sphanhoang/Self-balancing-robot/BreakoutBoard/BreakoutBoard.pdf

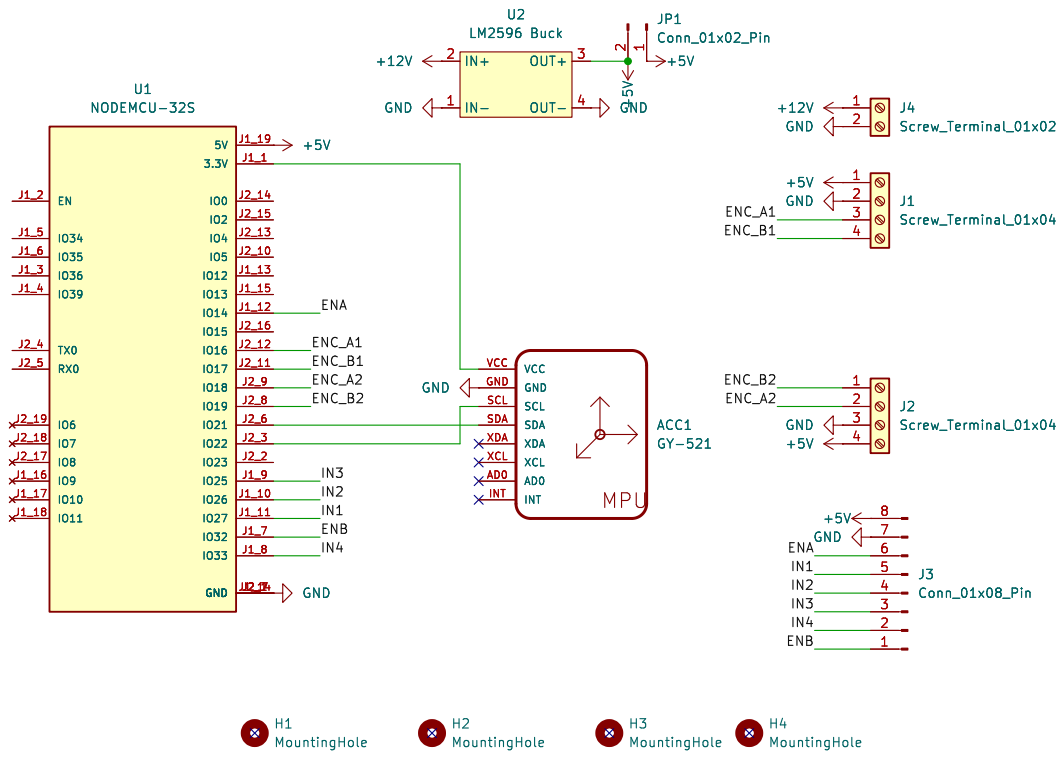
[picture p1: page 1]

Id: 1/1 Title: File: BreakoutBoard.kicad_sch Sheet: / MPU
