sphanhoang/Self-balancing-robot/BreakoutBoard/BreakoutBoard.kicad_pcb

## KiCad design BreakoutBoard/BreakoutBoard.kicad_pcb (2025-09-18)

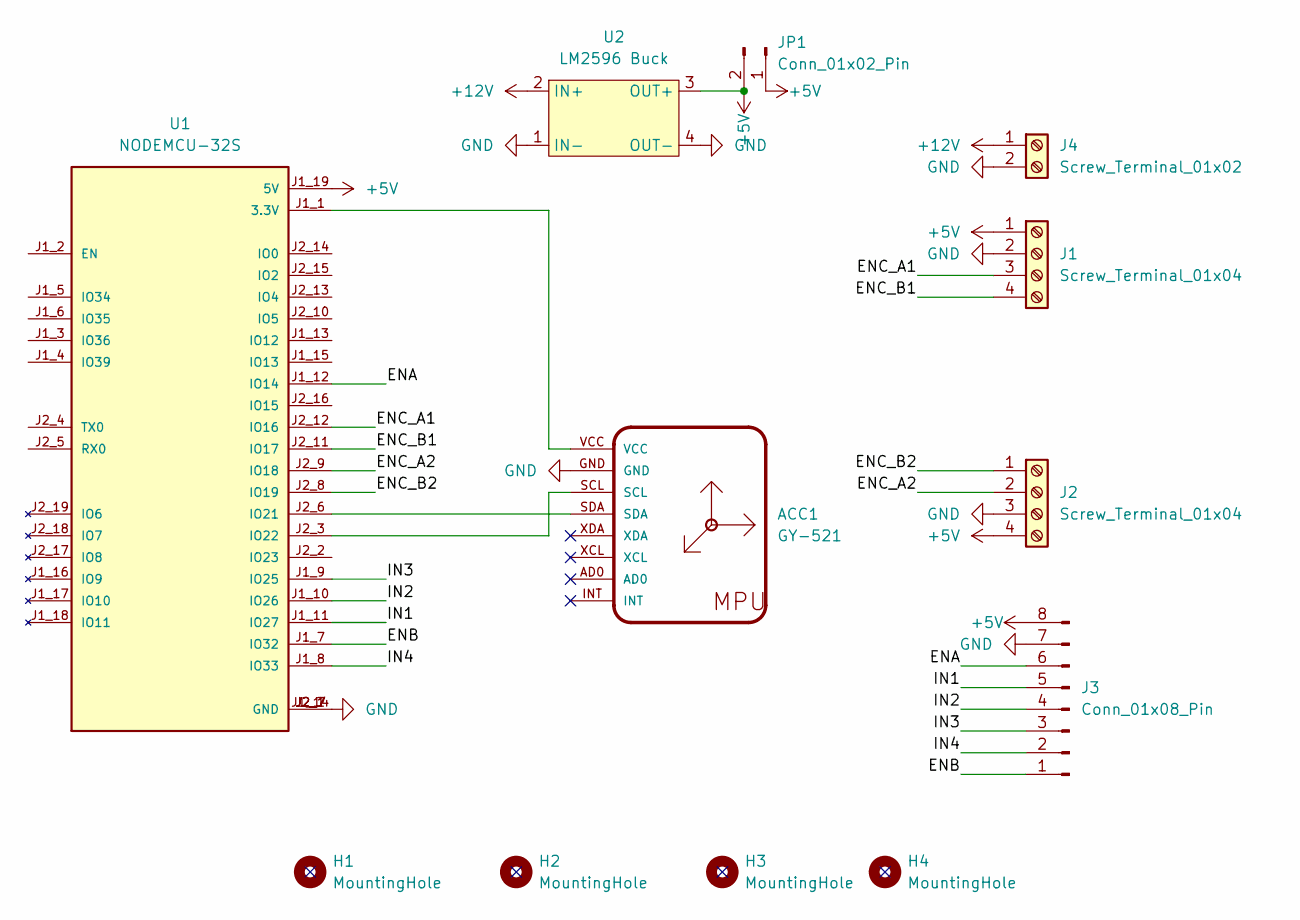
[picture p2: schematic BreakoutBoard.kicad_sch]

Parts:
ACC1: GY-521
H1, H2, H3, H4: MountingHole; MountingHole_3.2mm_M3_Pad
J1, J2: Screw_Terminal_01x04; ScrewTerminal_TB007-508-04BE
J3: Conn_01x08_Pin; PinHeader_1x08_P2.54mm_Vertical
J4: Screw_Terminal_01x02; ScrewTerminal_TB007-508-02BE
JP1: Conn_01x02_Pin; PinHeader_1x02_P2.54mm_Vertical
U1: NODEMCU-32S; ESP32-NODEMCU-32S; PARTREV V1
U2: LM2596 Buck; LM2596 WC00100 Module

Connections:
+5V: J1.1, J2.4, J3.8, JP1.1, JP1.2, U1.J1_19 (5V), U2.3 (OUT+)
+12V: J4.1, U2.2 (IN+)
/ENA: J3.6, U1.J1_12 (IO14)
/ENB: J3.1, U1.J1_7 (IO32)
/ENC_A1: J1.3, U1.J2_12 (IO16)
/ENC_A2: J2.2, U1.J2_9 (IO18)
/ENC_B1: J1.4, U1.J2_11 (IO17)
/ENC_B2: J2.1, U1.J2_8 (IO19)
/IN1: J3.5, U1.J1_11 (IO27)
/IN2: J3.4, U1.J1_10 (IO26)
/IN3: J3.3, U1.J1_9 (IO25)
/IN4: J3.2, U1.J1_8 (IO33)
GND: ACC1.GND, J1.2, J2.3, J3.7, J4.2, U1.J1_14 (GND), U1.J2_1 (GND), U1.J2_7 (GND), U2.1 (IN-), U2.4 (OUT-)
unnamed: ACC1.VCC, U1.J1_1 (3.3V)
unnamed: ACC1.SDA, U1.J2_6 (IO21)
unnamed: ACC1.SCL, U1.J2_3 (IO22)

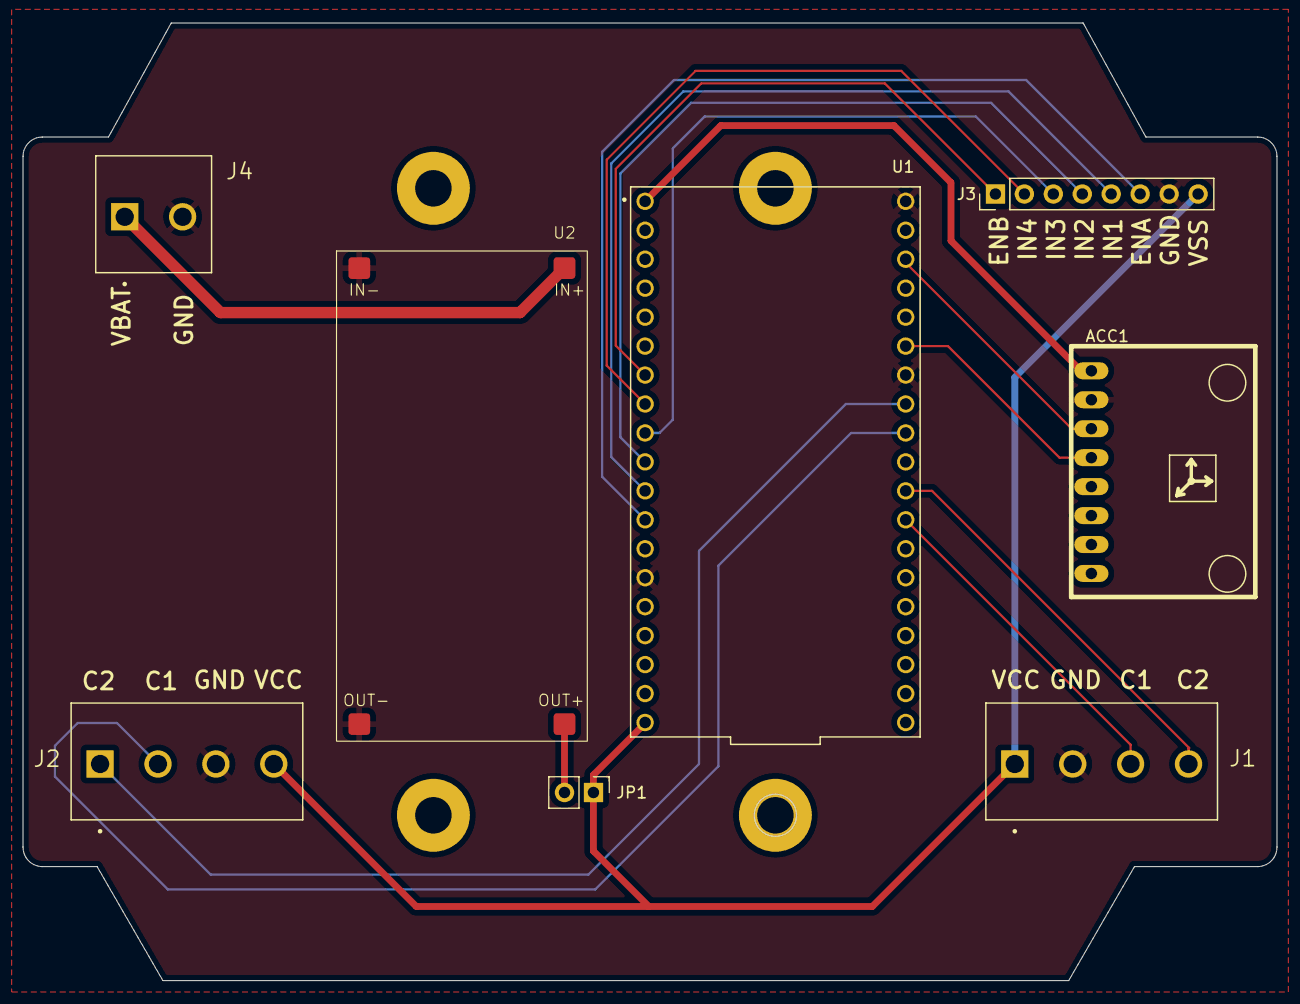
[picture p3: board BreakoutBoard.kicad_pcb from above]

Board: 4 copper layers, 110.0 x 84.0 mm, 12 parts (0 on the bottom side), 16 nets.
