sphanhoang/Self-balancing-robot/include/balance_robot.h

/**
 * @file balancing_robot.h
 * @brief Self-balancing robot control system header
 * @author Son Phan
 * @date Sept 2025
 */

#include "MPU6050.h"
#include "MPU6050_6Axis_MotionApps20.h"
#include "freertos/FreeRTOS.h"
#include "freertos/task.h"
#include "freertos/queue.h"
#include <freertos/semphr.h>
#include "esp_log.h"
#include "esp_timer.h"
#include "driver/gpio.h"
#include "driver/mcpwm.h"
#include "soc/mcpwm_periph.h"

#define PIN_SDA         21
#define PIN_CLK         22

/* Motor Pins assigment */
#define MOTOR_ENA_PIN   14  
#define MOTOR_ENB_PIN   32
#define MOTOR_IN1_PIN   27
#define MOTOR_IN2_PIN   26
#define MOTOR_IN3_PIN   25
#define MOTOR_IN4_PIN   33

/* Motor constrains */
#define MAX_MOTOR_SPEED 255.0f
#define MIN_MOTOR_SPEED 38.25f

/* PID parameter */
#define KP_ROLL 15.0f
#define KI_ROLL 5.0f
#define KD_ROLL 1.0f
#define KP_YAW 5.0f
#define KI_YAW 0.0f
#define KD_YAW 0.0f

/* PID constraints */
#define PID_INTEGRAL_CLAMP 50.0f
#define PID_OUTPUT_CLAMP 255.0f

/* Task freq */
#define MOTOR_UPDATE_FREQ_HZ 100  /* 100Hz */ 
#define SENSOR_READ_FREQ_HZ 100
#define CONTROL_LOOP_FREQ_HZ 100

// Data Structures
typedef struct 
{
    float yaw;
    float pitch;
    float roll;
    // float gyro_x;
    // float gyro_y;
    // float gyro_z;
    float accel_x;
    float accel_y;
    float accel_z;
    uint32_t timestamp;
} sensor_data_t;

typedef struct 
{
    float setpoint;
    float kp;
    float ki;
    float kd;
    float integral;
    float previous_error;
    float output;
} pid_controller_t;

typedef struct 
{
    float roll_output;
    float yawRate_output;
    float left_motor_speed;
    float right_motor_speed;
    float left_motor_feedback;
    float right_motor_feedback;
    uint32_t timestamp;
} control_data_t;

void initI2C(void);
void mpu_setup(MPU6050 &mpu);
void sensor_task (void *pvParameters);
float compute_pid(pid_controller_t *pid, float setpoint, float feedback, float dt);
void control_task(void *pvParameters);
esp_err_t motor_init(void);
void set_motor_speed(int motor, float *speed);
void motor_task (void *pvParameters);
void monitor_task(void *pvParameters);
