sphanhoang/Self-balancing-robot/(commit log)

2025-09-18 added breakout board schematic folder
    [BreakoutBoard-B_Mask.gbs, BreakoutBoard-B_Paste.gbp, BreakoutBoard-B_Silkscreen.gbo, BreakoutBoard-Back.gbl, BreakoutBoard-Edge_Cuts.gm1, BreakoutBoard-F_Mask.gts, BreakoutBoard-F_Paste.gtp, BreakoutBoard-F_Silkscreen.gto]
2025-09-19 fixed various error. Sensor reading but no PWM
    [balancing_robot.h, main.cpp]
2025-09-20 drive motor using mcpwm lib
2025-09-20 lower PWM frequency for L298 driver to pickup low duty cycle
2025-09-22 robot is running, need further PID tuning
2025-09-22 resolve wrong main.cpp after merge
    [balance_robot.h, main.cpp]
2025-09-22 rename balance_robot.h header -> balancing_robot.h and refactor main.cpp for PID control
2025-09-23 refactor: improve PID controller structure and add mutex for sensor data access
2025-09-24 Lower I2C clock to fix DMP reading issue
    [balancing_robot.h, main.cpp]
2025-09-24 add encoder pin assignments
2025-09-24 first iteration for PID speed control
2025-09-25 move encoder reading to a seperate task
2025-09-25 Refactor: Remove LibDriverMPU6050 interface implementation
    - Deleted esp32_driver_mpu6050_interface.c as it is no longer needed.
    - Updated platformio.ini to remove references to LibDriverMPU6050 directories.
    - Modified main.cpp to include MPU6050 and MPU6050_6Axis_MotionApps20 headers.
    - Adjusted roll PID setpoint to 0.0f for better control.
    - Added web control functionality with a new web_interface.cpp file.
    - Implemented web server for real-time data visualization and PID tuning.
    - Introduced mutex for web control parameters to ensure thread safety.
    - Enhanced encoder interrupt handlers to determine rotation direction.
    [balancing_robot.h, main.cpp, web_interface.cpp]
2025-09-30 Refactor: Update PID parameters and improve web interface functionality
2025-09-30 Refactor: Update PID parameters and remove web control header
